solucca/FIWARE-SmartTrain/SmartTrain/TODO.md

[] - Write Documentation
[] - (Maybe) add cmdexe response
[] - create color codded
[] - add repository to github
