solucca/FIWARE-SmartTrain/(notices)

Notices in the files:
README.md:
License: MIT
